CHIP-SHED/B.O.B./README.md

Battery On Board B.O.B.  

Add battery power and LiPo charging to your Raspberry Pi projects.

======  

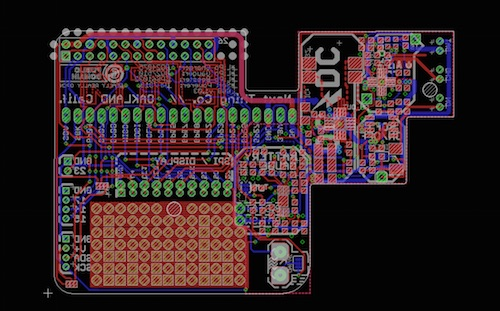
[picture p1: bob.jpg]
Battery On Board B.O.B.
