CHIP-SHED/B.O.B./BOB v0.6/BOB v0.6.pdf

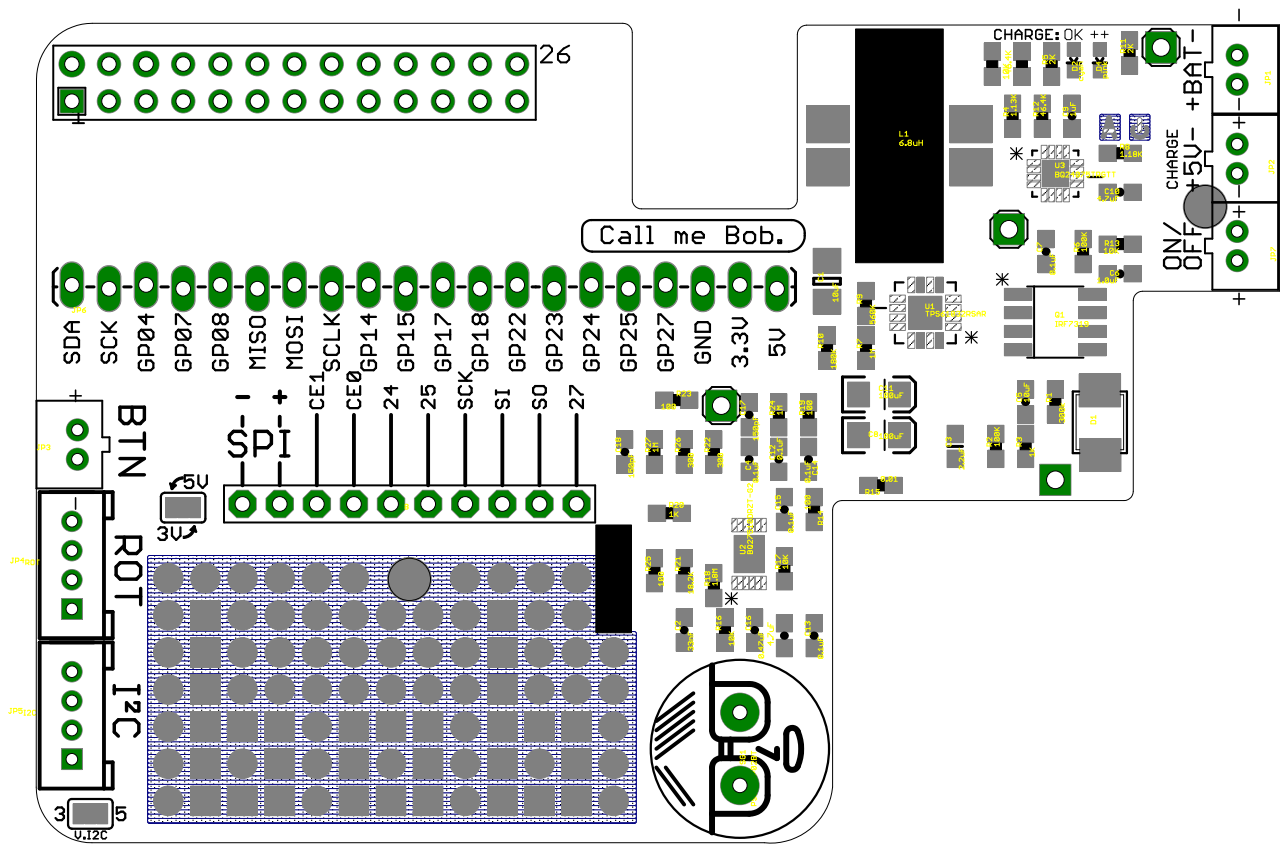
[picture p2: page 1]
