CHIP-SHED/B.O.B./BOB v0.6/BOB v0.6 Unrouted/BOB v0.6.pdf

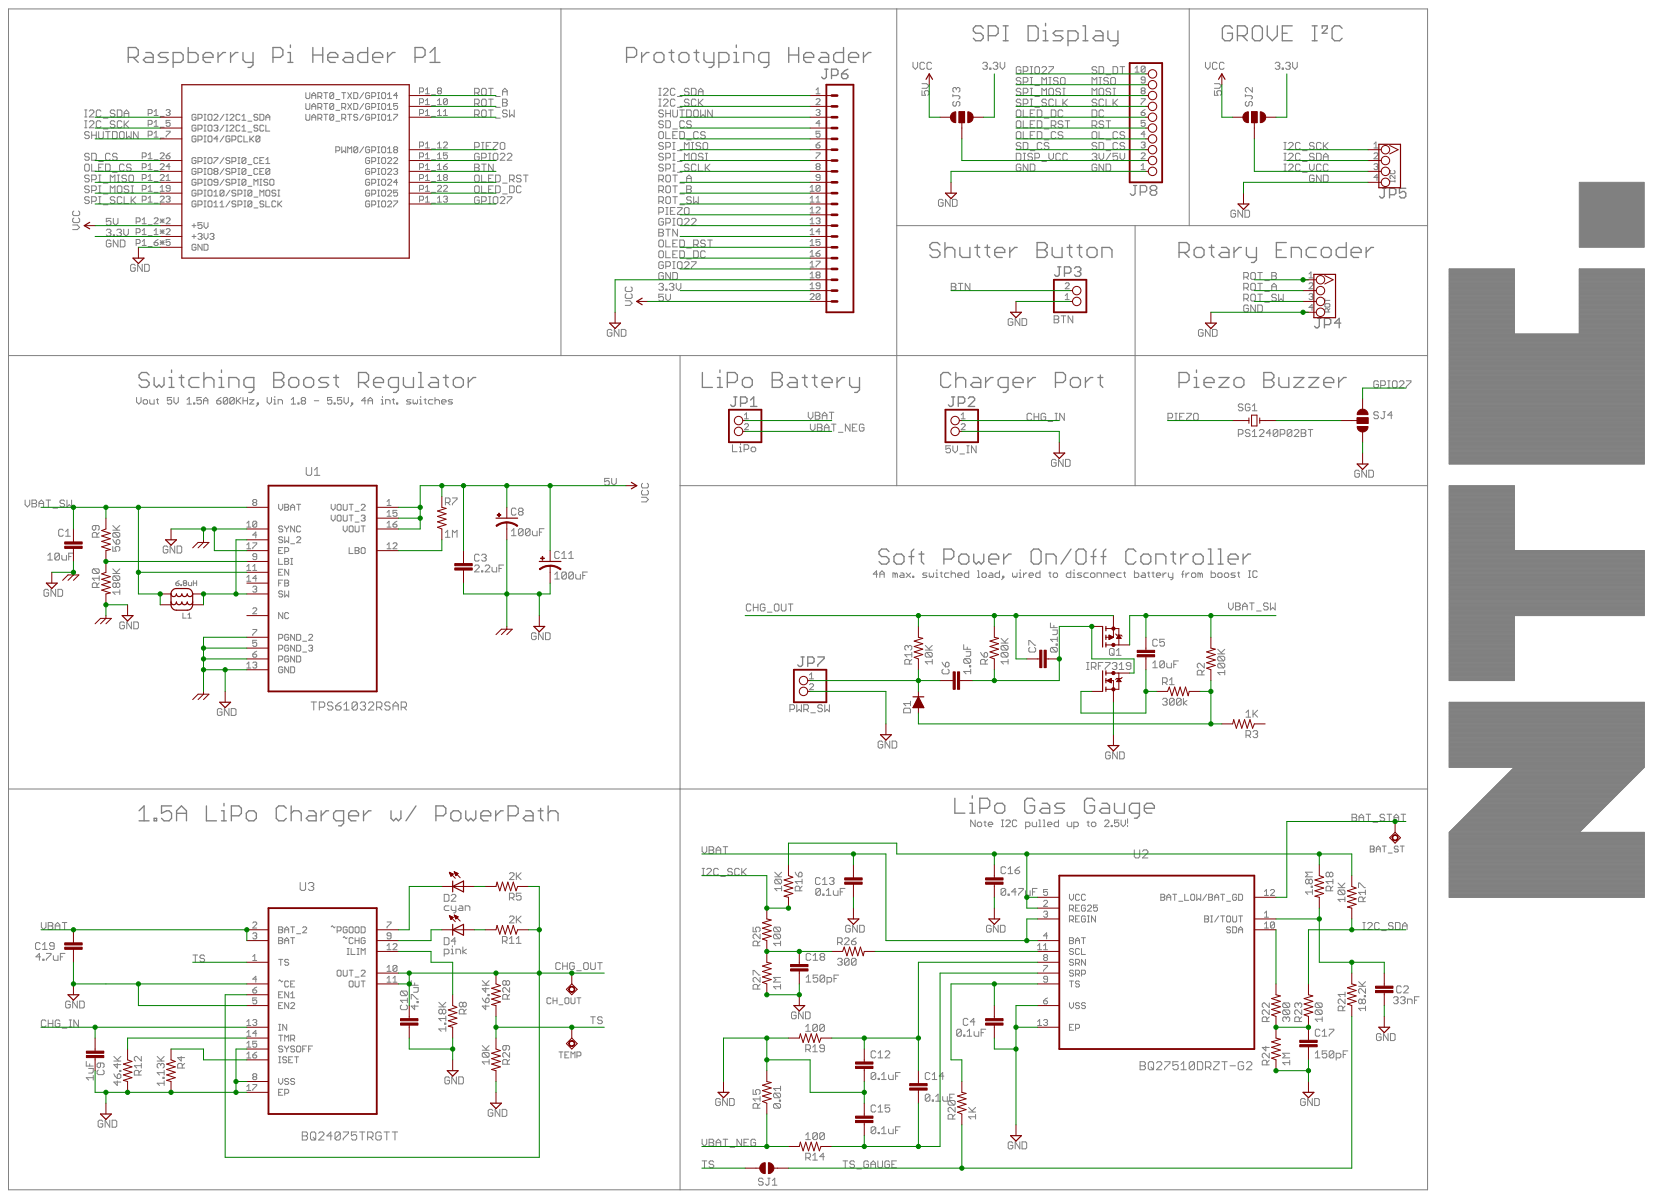
[picture p3: page 1]
