CHIP-SHED/B.O.B./BOB v0/Untitled.brd

## EAGLE design BOB v0/Untitled.brd (2014-11-20, an earlier design)

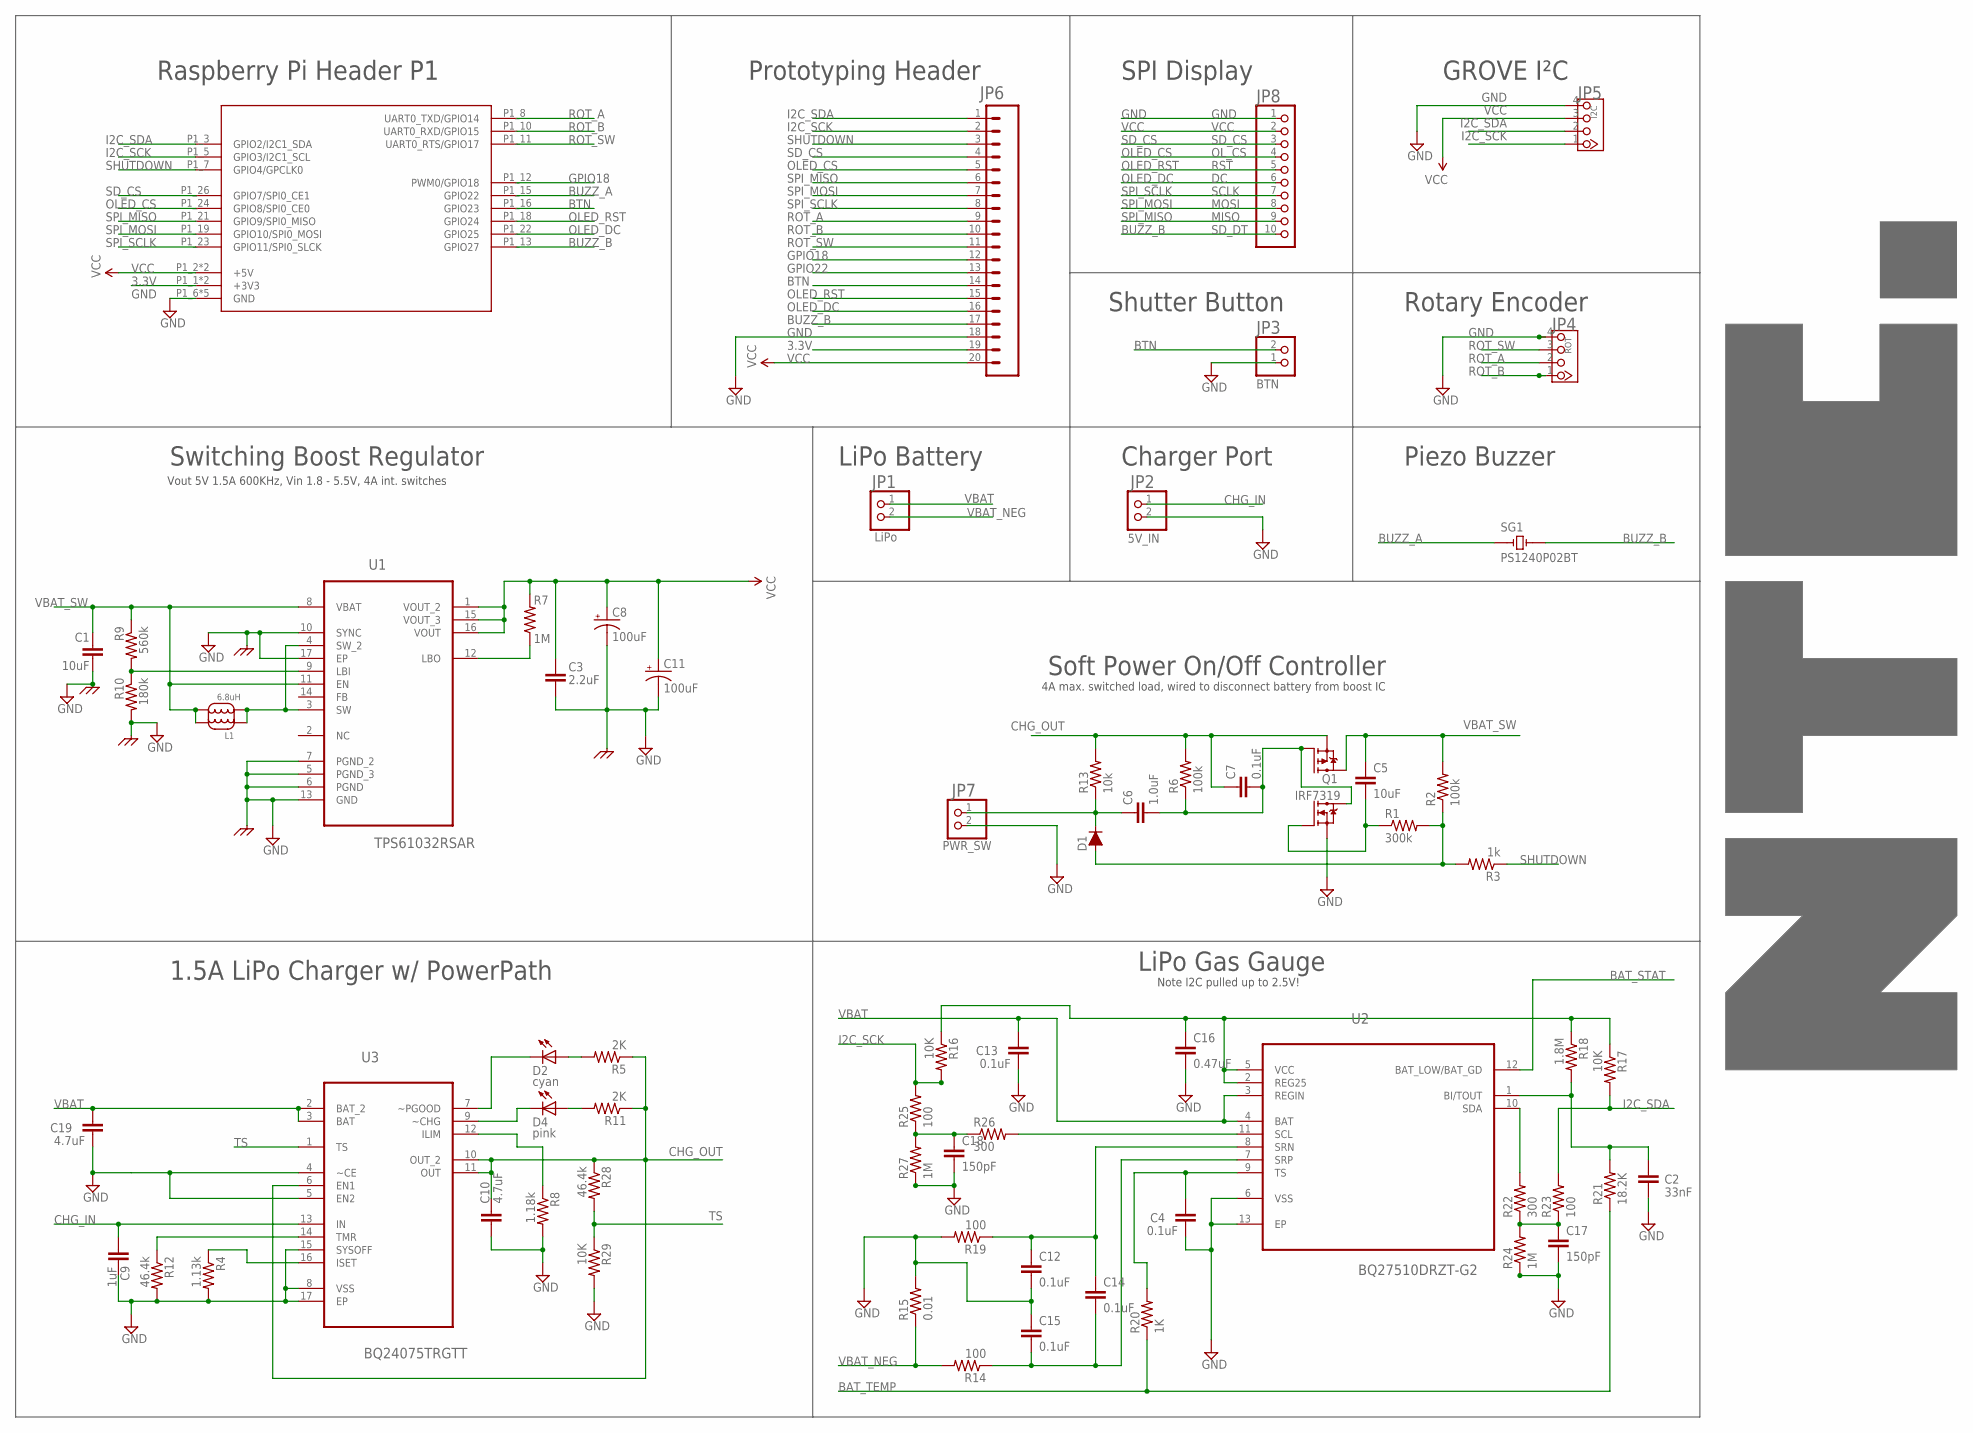
[picture p4: schematic Untitled.sch, sheet 1, Pi Cam Daughterboard]

Parts:
C1: 10uF; 1206
C2: 33nF; 0603-CAP
C3: 2.2uF; 0603
C4, C7, C12, C13, C14, C15: 0.1uF; 0603-CAP
C5: 10uF; 0603-CAP
C6: 1.0uF; 0603-CAP
C8, C11: 100uF; EIA3216
C9: 1uF; 0603-CAP
C10, C19: 4.7uF; 0603-CAP
C16: 0.47uF; 0603-CAP
C17, C18: 150pF; 0603-CAP
D1: D-FILL-SMB; SMB
D2: cyan; LED-0603
D4: pink; LED-0603
JP1: LiPo; JST-PH-2-THM-RA
JP2: 5V_IN; JST-PH-2-THM-RA
JP3: BTN; JST-PH-2-THM-RA
JP4: ROT; CONNECTOR_4P-2.0-90D
JP5: I2C; CONNECTOR_4P-2.0-90D
JP6: M20LOCK_LONGPADS; 1X20_LOCK_LONGPADS
JP7: PWR_SW; JST-PH-2-THM-RA
JP8: PINHD-1X10; 1X10-BIG
L1: 6.8uH; SUMIDA_CDRH124
PICAM_SHIELD: PICAM_RPI-B-PICAM
Q1: IRF7319; SO08-IRF
R1: 300k; 0603-RES
R2, R6: 100k; 0603-RES
R3: 1k; 0603-RES
R4: 1.13k; 0603-RES
R5, R11: 2K; 0603-RES
R7: 1M; 0603-RES
R8: 1.18k; 0603-RES
R9: 560k; 0603-RES
R10: 180k; 0603-RES
R12, R28: 46.4k; 0603-RES
R13: 10k; 0603-RES
R14, R19: 100; 0603-RES
R15: 0.01; SPARKFUN_1206
R16, R17, R29: 10K; 0603-RES
R18: 1.8M; 0603-RES
R20: 1K; SPARKFUN_1206
R21: 18.2K; SPARKFUN_1206
R22, R26: 300; SPARKFUN_1206
R23, R25: 100; SPARKFUN_1206
R24, R27: 1M; SPARKFUN_1206
SG1: PS1240P02BT; PS1240
U1: TPS61032RSAR; QFN65P400X400X100-17N
U2: BQ27510DRZT-G2; SON40P400X250X100-13N
U3: BQ24075TRGTT; QFN50P300X300X100-17N

Connections:
3.3V: JP6.19, PICAM_SHIELD.P1_1 (+3V3), PICAM_SHIELD.P1_17 (+3V3)
BAT_STAT: U2.12 (BAT_LOW/BAT_GD)
BAT_TEMP: R20.1, R21.1
BTN: JP3.2 (1), JP6.14, PICAM_SHIELD.P1_16 (GPIO23)
BUZZ_A: PICAM_SHIELD.P1_15 (GPIO22), SG1.P$1 (1)
BUZZ_B: JP6.17, JP8.10, PICAM_SHIELD.P1_13 (GPIO27), SG1.P$2 (2)
CHG_IN: C9.1, JP2.1 (2), U3.13 (IN)
CHG_OUT: C7.1, C10.1, Q1.3 (P-S2), R5.1, R6.2, R11.1, R13.2, R28.1, U3.6 (EN1), U3.10 (OUT_2), U3.11 (OUT)
GND: C1.2, C2.2, C3.2, C4.2, C8.C (-), C9.2, C10.2, C11.C (-), C12.2, C13.2, C15.1, C16.2, C17.2, C18.2, C19.2, JP2.2 (1), JP3.1 (2), JP4.4, JP5.4, JP6.18, JP7.2 (1), JP8.1, PICAM_SHIELD.P1_6 (GND), PICAM_SHIELD.P1_9 (GND), PICAM_SHIELD.P1_14 (GND), PICAM_SHIELD.P1_20 (GND), PICAM_SHIELD.P1_25 (GND), Q1.1 (N-S1), R4.2, R8.2, R10.2, R12.2, R15.2, R19.2, R24.1, R27.1, R29.2, U1.5 (PGND_3), U1.6 (PGND), U1.7 (PGND_2), U1.10 (SYNC), U1.13 (GND), U1.17 (EP), U2.6 (VSS), U2.13 (EP), U3.4 (~CE), U3.5 (EN2), U3.8 (VSS), U3.15 (SYSOFF), U3.17 (EP)
GPIO18: JP6.12, PICAM_SHIELD.P1_12 (PWM0/GPIO18)
GPIO22: JP6.13
I2C_SCK: JP5.1, JP6.2, PICAM_SHIELD.P1_5 (GPIO3/I2C1_SCL), R16.2, R25.2
I2C_SDA: JP5.2, JP6.1, PICAM_SHIELD.P1_3 (GPIO2/I2C1_SDA), R17.2, R23.2
L1: L1.P$3 (2), L1.P$4 (2), U1.3 (SW), U1.4 (SW_2)
unnamed: C6.1, D1.1 (C), JP7.1 (2), R13.1
unnamed: C2.1, R18.2, R21.2, U2.1 (BI/TOUT)
unnamed: C17.1, R22.1, R23.1, R24.2
unnamed: D4.C, U3.9 (~CHG)
unnamed: R7.1, U1.12 (LBO)
unnamed: R9.2, R10.1, U1.9 (LBI)
unnamed: R12.1, U3.14 (TMR)
unnamed: C5.2, Q1.2 (N-G1), R1.1
unnamed: R4.1, U3.16 (ISET)
unnamed: D4.A, R11.2
unnamed: D2.C, U3.7 (~PGOOD)
unnamed: D2.A, R5.2
unnamed: C6.2, C7.2, Q1.4 (P-G2), Q1.7 (N-D1), Q1.8 (N-D1), R6.1
unnamed: D1.2 (A), R1.2, R2.1, R3.2
unnamed: R22.2, U2.10 (SDA)
unnamed: C18.1, R25.1, R26.1, R27.2
unnamed: R8.1, U3.12 (ILIM)
unnamed: R26.2, U2.11 (SCL)
unnamed: C4.1, R20.2, U2.9 (TS)
unnamed: C16.1, R16.1, R17.1, R18.1, U2.2 (REG25), U2.5 (VCC)
OLED_CS: JP6.5, JP8.4, PICAM_SHIELD.P1_24 (GPIO8/SPI0_CE0)
OLED_DC: JP6.16, JP8.6, PICAM_SHIELD.P1_22 (GPIO25)
OLED_RST: JP6.15, JP8.5, PICAM_SHIELD.P1_18 (GPIO24)
ROT_A: JP4.2, JP6.9, PICAM_SHIELD.P1_8 (UART0_TXD/GPIO14)
ROT_B: JP4.1, JP6.10, PICAM_SHIELD.P1_10 (UART0_RXD/GPIO15)
ROT_SW: JP4.3, JP6.11, PICAM_SHIELD.P1_11 (UART0_RTS/GPIO17)
SD_CS: JP6.4, JP8.3, PICAM_SHIELD.P1_26 (GPIO7/SPI0_CE1)
SHUTDOWN: JP6.3, PICAM_SHIELD.P1_7 (GPIO4/GPCLK0), R3.1
SPI_MISO: JP6.6, JP8.9, PICAM_SHIELD.P1_21 (GPIO9/SPI0_MISO)
SPI_MOSI: JP6.7, JP8.8, PICAM_SHIELD.P1_19 (GPIO10/SPI0_MOSI)
SPI_SCLK: JP6.8, JP8.7, PICAM_SHIELD.P1_23 (GPIO11/SPI0_SLCK)
SRN: C12.1, C14.1, R19.1, U2.8 (SRN)
SRP: C14.2, C15.2, R14.1, U2.7 (SRP)
TS: R28.2, R29.1, U3.1 (TS)
VBAT: C13.1, C19.1, JP1.1 (2), U2.3 (REGIN), U2.4 (BAT), U3.2 (BAT_2), U3.3 (BAT)
VBAT_NEG: JP1.2 (1), R14.2, R15.1
VBAT_SW: C1.1, C5.1, L1.P$1 (1), L1.P$2 (1), Q1.5 (P-D2), Q1.6 (P-D2), R2.2, R9.1, U1.8 (VBAT), U1.11 (EN)
VCC: C3.1, C8.A (+), C11.A (+), JP5.3, JP6.20, JP8.2, PICAM_SHIELD.P1_2 (+5V), PICAM_SHIELD.P1_4 (+5V), R7.2, U1.1 (VOUT_2), U1.15 (VOUT_3), U1.16 (VOUT)

Notes on the sheet:
Switching Boost Regulator
1.5A LiPo Charger w/ PowerPath
Rotary Encoder
GROVE I²C
Shutter Button
Soft Power On/Off Controller
SPI Display
RST
OL_CS
SD_CS
VCC
GND
SCLK
MOSI
MISO
SD_DT
Prototyping Header
Raspberry Pi Header P1
LiPo Gas Gauge
4A max. switched load, wired to disconnect battery from boost IC
Vout 5V 1.5A 600KHz, Vin 1.8 - 5.5V, 4A int. switches
Piezo Buzzer
Charger Port
LiPo Battery
Note I2C pulled up to 2.5V!

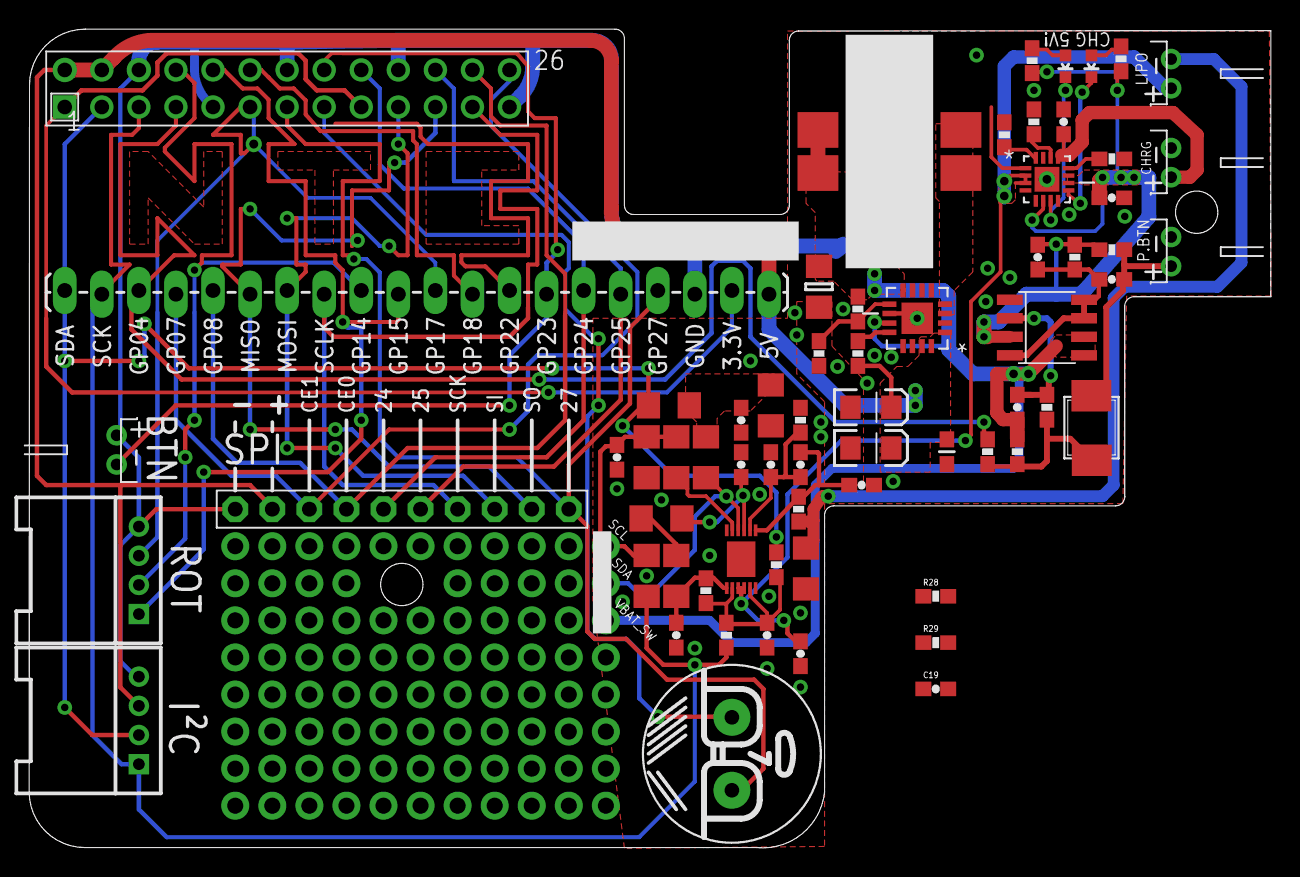
[picture p5: board Untitled.brd from above]

Board: 2 copper layers, 85.1 x 56.1 mm, 66 parts (0 on the bottom side), 50 nets.
