CHIP-SHED/B.O.B./(commit log)

2014-11-20 all versions...
    [BOB v0.6.GBL, BOB v0.6.GBO, BOB v0.6.GBP, BOB v0.6.GBS, BOB v0.6.GTL, BOB v0.6.GTO, BOB v0.6.GTP, BOB v0.6.GTS]
2014-11-20 Add board image to Readme
